rvasquez6089/Senior-Design-VFD/Inverter/3.3V2.5A Microcontroller Power/readme.txt

**********************************************************
*************  Important Instructions Follow  ************
**********************************************************

All files exported to: Z:\\17\\70\\1770687\\26\Altium\2016-06-17_13-27-20\2016-06-17_13-27-20

**********************************************************
***************** Schematic Instructions  ****************
**********************************************************

To import your new Schematic into Altium:

1. Unzip the downloaded folder files to a local directory and
Start the Altium program.
2. From the menu select "File"->"Open".
3. Select the file named in the path above ending with ".sch"
and "Open" the file.
4. Your Schematic should be viewable within Altium now.

For additional information, please visit this site:
http://www.accelerated-designs.com/help/Altium_BrdSch_import.html

**********************************************************
*******************  PCB Instructions  *******************
**********************************************************

To import your new BOARD into Altium:

1. Unzip the downloaded folder files to a local directory
	and Start the Altium program.
2. From the menu select "File"->"Open".
3. Select the file named in the path above ending with ".pcbdoc"
and "Open" the file.
4. Planes will need to be repoured to update the Copper Pour Polygons
	a. Once your board is loaded, select the Tools menu from the
	   top Menu Bar
	b. Scroll to the Polygon Pours item on the Tools Menu.
	c. The Polygon Pours item should expand to show more options
	d. Select Repour All Polygons, this will repour all of the
	   polygons.
5. Your board should be viewable within Altium now.

For additional information, please visit this site:
http://www.accelerated-designs.com/help/Altium_BrdSch_import.html

**********************************************************
*******************  LIB Instructions  *******************
**********************************************************

To import your new LIBRARY PARTS into Altium follow these steps:

1. After running the Ultra Librarian export for the first time,
you will need to copy the following files into an area where
they can be accessed for all future translations.  They are script
files that Altium will need to be able to find.
	a. UL_Form.dfm
	b. UL_Form.pas
	c. UL_Import.pas
	d. UL_Import.prjScr
2. The above script file will need to be run from within Altium.
This can be done by going to File, Open and selecting the
UL_Import.PrjScr file stored above.
3. Select the "DXP" dropdown menu in the top-left corner runfrom
the drop down menu and select "Run Script". Select "UL_Form.pas"
and click "OK"
4. When the script is run, it will ask you for the file name of the
Ultra Librarian file to run. Click "File...", select the latest file
produced with a date code (for instance 2010-02-17_23-12-34.txt), and
click "Start Import".
5. The script will open a new Integraged Library project and import
the Ultra Librarian data into it.  When complete a message box
will pop up saying that import is done.

For additional information, please visit this site:
http://www.accelerated-designs.com/help/Altium_import.html

For a video tutorial, please visit:
http://youtu.be/pih50yx9HYU

**********************************************************
**********************************************************
**********************************************************

Symbol "WB_STARTUP_VOLTAGE_SOURCE" renamed to "WB_STARTUP_VOLTA"
Symbol "WB_SOURCE_RESISTOR" renamed to "WB_SOURCE_RESIST"
Symbol "WB_PRIM_STARTUP_VOLTAGE_SOURCE" renamed to "WB_PRIM_STARTUP_"
Symbol "WB_PRIM_DC_VOLTAGE_SOURCE" renamed to "WB_PRIM_DC_VOLTA"
Symbol "WB_PWL_CURRENT_LOAD" renamed to "WB_PWL_CURRENT_L"
Symbol "WB_ZERO_VOLT_SOURCE" renamed to "WB_ZERO_VOLT_SOU"
Symbol "WB_PWL_VOLTAGE_SOURCE" renamed to "WB_PWL_VOLTAGE_S"
Symbol "WB_PRIM_PWL_VOLTAGE_SOURCE" renamed to "WB_PRIM_PWL_VOLT"
Symbol "WB_PRIMITIVE_BATTERY" renamed to "WB_PRIMITIVE_BAT"
Symbol "WB_TPS54329_EN_WIRE" renamed to "WB_TPS54329_EN_W"
Component "C0805C100M4GACTU" renamed to "C0805C100M4GACTU"
Component "GRM155R61A104KA01D" renamed to "GRM155R61A104KA0"
Component "WB_CONTINUATION" renamed to "WB_CONTINUATION"
Component "C3216JB1A476M" renamed to "C3216JB1A476M"
Component "GRM188R61A105KA61D" renamed to "GRM188R61A105KA6"
Component "GRM033R61A822KA01D" renamed to "GRM033R61A822KA0"
Component "WB_GND" renamed to "WB_GND"
Component "CLF7045T-3R3N" renamed to "CLF7045T-3R3N"
Component "CRCW040210K0FKED" renamed to "CRCW040210K0FKED"
Component "CRCW040225K5FKED" renamed to "CRCW040225K5FKED"
Component "CRCW040284K5FKED" renamed to "CRCW040284K5FKED"
Component "TPS54339DDAR" renamed to "TPS54339DDAR"
Component "WB_BATTERY" renamed to "WB_BATTERY"
Component "GRM155R60J225ME15D" renamed to "GRM155R60J225ME1"
Component "SLC7649S-101KLB" renamed to "SLC7649S-101KLB"
Component "WB_CURRENT_LOAD" renamed to "WB_CURRENT_LOAD"
Component "GRM32ER7YA106KA12L" renamed to "GRM32ER7YA106KA1"
The Symbol WB_BLOCK_IO was missing a RefDes attribute, a refdes was created for the symbol.
The Symbol WB_BLOCK_IO was missing a Type attribute, a type was created for the symbol.
The Symbol WB_BLOCK_IO was missing a Value attribute, a value was created for the symbol.
The Symbol WB_STARTUP_VOLTA was missing a RefDes attribute, a refdes was created for the symbol.
The Symbol WB_STARTUP_VOLTA was missing a Type attribute, a type was created for the symbol.
The Symbol WB_STARTUP_VOLTA was missing a Value attribute, a value was created for the symbol.
The Symbol WB_SOURCE_RESIST was missing a RefDes attribute, a refdes was created for the symbol.
The Symbol WB_SOURCE_RESIST was missing a Type attribute, a type was created for the symbol.
The Symbol WB_SOURCE_RESIST was missing a Value attribute, a value was created for the symbol.
The Symbol WB_PRIM_STARTUP_ was missing a RefDes attribute, a refdes was created for the symbol.
The Symbol WB_PRIM_STARTUP_ was missing a Type attribute, a type was created for the symbol.
The Symbol WB_PRIM_STARTUP_ was missing a Value attribute, a value was created for the symbol.
The Symbol WB_PRIM_DC_VOLTA was missing a RefDes attribute, a refdes was created for the symbol.
The Symbol WB_PRIM_DC_VOLTA was missing a Type attribute, a type was created for the symbol.
The Symbol WB_PRIM_DC_VOLTA was missing a Value attribute, a value was created for the symbol.
The Symbol WB_CURRENT_PROBE was missing a RefDes attribute, a refdes was created for the symbol.
The Symbol WB_CURRENT_PROBE was missing a Type attribute, a type was created for the symbol.
The Symbol WB_CURRENT_PROBE was missing a Value attribute, a value was created for the symbol.
The Symbol WB_PWL_CURRENT_L was missing a RefDes attribute, a refdes was created for the symbol.
The Symbol WB_PWL_CURRENT_L was missing a Type attribute, a type was created for the symbol.
The Symbol WB_PWL_CURRENT_L was missing a Value attribute, a value was created for the symbol.
The Symbol WB_ZERO_VOLT_SOU was missing a RefDes attribute, a refdes was created for the symbol.
The Symbol WB_ZERO_VOLT_SOU was missing a Type attribute, a type was created for the symbol.
The Symbol WB_ZERO_VOLT_SOU was missing a Value attribute, a value was created for the symbol.
The Symbol WB_PWL_VOLTAGE_S was missing a RefDes attribute, a refdes was created for the symbol.
The Symbol WB_PWL_VOLTAGE_S was missing a Type attribute, a type was created for the symbol.
The Symbol WB_PWL_VOLTAGE_S was missing a Value attribute, a value was created for the symbol.
The Symbol WB_PRIM_PWL_VOLT was missing a RefDes attribute, a refdes was created for the symbol.
The Symbol WB_PRIM_PWL_VOLT was missing a Type attribute, a type was created for the symbol.
The Symbol WB_PRIM_PWL_VOLT was missing a Value attribute, a value was created for the symbol.
The Symbol WB_LOAD_RESISTOR was missing a RefDes attribute, a refdes was created for the symbol.
The Symbol WB_LOAD_RESISTOR was missing a Type attribute, a type was created for the symbol.
The Symbol WB_LOAD_RESISTOR was missing a Value attribute, a value was created for the symbol.
The Symbol WB_PRIMITIVE_BAT was missing a RefDes attribute, a refdes was created for the symbol.
The Symbol WB_PRIMITIVE_BAT was missing a Type attribute, a type was created for the symbol.
The Symbol WB_PRIMITIVE_BAT was missing a Value attribute, a value was created for the symbol.
The Symbol WB_CFF_BLOCK was missing a RefDes attribute, a refdes was created for the symbol.
The Symbol WB_CFF_BLOCK was missing a Type attribute, a type was created for the symbol.
The Symbol WB_CFF_BLOCK was missing a Value attribute, a value was created for the symbol.
The Symbol WB_TPS54339 was missing a RefDes attribute, a refdes was created for the symbol.
The Symbol WB_TPS54339 was missing a Type attribute, a type was created for the symbol.
The Symbol WB_TPS54339 was missing a Value attribute, a value was created for the symbol.
The Symbol WB_VOLTAGE_PROBE was missing a RefDes attribute, a refdes was created for the symbol.
The Symbol WB_VOLTAGE_PROBE was missing a Type attribute, a type was created for the symbol.
The Symbol WB_VOLTAGE_PROBE was missing a Value attribute, a value was created for the symbol.
The Symbol WB_TPS54329_EN_W was missing a RefDes attribute, a refdes was created for the symbol.
The Symbol WB_TPS54329_EN_W was missing a Type attribute, a type was created for the symbol.
The Symbol WB_TPS54329_EN_W was missing a Value attribute, a value was created for the symbol.
The Symbol WB_TPS54329_VEN was missing a RefDes attribute, a refdes was created for the symbol.
The Symbol WB_TPS54329_VEN was missing a Type attribute, a type was created for the symbol.
The Symbol WB_TPS54329_VEN was missing a Value attribute, a value was created for the symbol.
WARNING schematic has been cleaned of missing information entries.
Warning: Symbol "WB_CAPACITOR" attribute "Datasheet URL" references missing text style ""
Warning: Symbol "WB_CAPACITOR" attribute "Cap" references missing text style ""
Warning: Symbol "WB_CAPACITOR" attribute "ESR" references missing text style ""
Warning: Symbol "WB_CAPACITOR" attribute "IRMS" references missing text style ""
Warning: Symbol "WB_CAPACITOR" attribute "VDC" references missing text style ""
Warning: Symbol "WB_CAPACITOR" attribute "Cap" references missing text style ""
Warning: Symbol "WB_CAPACITOR" attribute "ESR" references missing text style ""
Warning: Symbol "WB_CAPACITOR" attribute "IRMS" references missing text style ""
Warning: Symbol "WB_CAPACITOR" attribute "VDC" references missing text style ""
Warning: Symbol "WB_CAPACITOR" attribute "Datasheet URL" references missing text style ""
Warning: Symbol "WB_CAPACITOR" attribute "Cap" references missing text style ""
Warning: Symbol "WB_CAPACITOR" attribute "ESR" references missing text style ""
Warning: Symbol "WB_CAPACITOR" attribute "IRMS" references missing text style ""
Warning: Symbol "WB_CAPACITOR" attribute "VDC" references missing text style ""
Warning: Symbol "WB_CAPACITOR" attribute "Cap" references missing text style ""
Warning: Symbol "WB_CAPACITOR" attribute "ESR" references missing text style ""
Warning: Symbol "WB_CAPACITOR" attribute "IRMS" references missing text style ""
Warning: Symbol "WB_CAPACITOR" attribute "VDC" references missing text style ""
Warning: Symbol "WB_CAPACITOR" attribute "Cap" references missing text style ""
Warning: Symbol "WB_CAPACITOR" attribute "ESR" references missing text style ""
Warning: Symbol "WB_CAPACITOR" attribute "IRMS" references missing text style ""
Warning: Symbol "WB_CAPACITOR" attribute "VDC" references missing text style ""
Warning: Symbol "WB_INDUCTOR" attribute "Datasheet URL" references missing text style ""
Warning: Symbol "WB_INDUCTOR" attribute "L" references missing text style ""
Warning: Symbol "WB_INDUCTOR" attribute "DCR" references missing text style ""
Warning: Symbol "WB_INDUCTOR" attribute "IDC" references missing text style ""
Warning: Symbol "WB_RESISTOR" attribute "Resistance" references missing text style ""
Warning: Symbol "WB_RESISTOR" attribute "Power" references missing text style ""
Warning: Symbol "WB_RESISTOR" attribute "Tolerance" references missing text style ""
Warning: Symbol "WB_RESISTOR" attribute "Resistance" references missing text style ""
Warning: Symbol "WB_RESISTOR" attribute "Power" references missing text style ""
Warning: Symbol "WB_RESISTOR" attribute "Tolerance" references missing text style ""
Warning: Symbol "WB_RESISTOR" attribute "Resistance" references missing text style ""
Warning: Symbol "WB_RESISTOR" attribute "Power" references missing text style ""
Warning: Symbol "WB_RESISTOR" attribute "Tolerance" references missing text style ""
Warning: Symbol "TPS54339DDAR" attribute "Datasheet URL" references missing text style ""
Warning: Symbol "TPS54339DDAR" attribute "Frequency" references missing text style ""
Warning: Symbol "TPS54339DDAR" attribute "Imax" references missing text style ""
Warning: Symbol "TPS54339DDAR" attribute "Package" references missing text style ""
Warning: Symbol "TPS54339DDAR" attribute "Mktg_Package" references missing text style ""
Warning: Symbol "TPS54339DDAR" attribute "NSID" references missing text style ""
Warning: Symbol "WB_CAPACITOR" attribute "Datasheet URL" references missing text style ""
Warning: Symbol "WB_CAPACITOR" attribute "Cap" references missing text style ""
Warning: Symbol "WB_CAPACITOR" attribute "ESR" references missing text style ""
Warning: Symbol "WB_CAPACITOR" attribute "IRMS" references missing text style ""
Warning: Symbol "WB_CAPACITOR" attribute "VDC" references missing text style ""
Warning: Symbol "WB_INDUCTOR" attribute "Datasheet URL" references missing text style ""
Warning: Symbol "WB_INDUCTOR" attribute "L" references missing text style ""
Warning: Symbol "WB_INDUCTOR" attribute "DCR" references missing text style ""
Warning: Symbol "WB_INDUCTOR" attribute "IDC" references missing text style ""
Warning: Symbol "WB_CAPACITOR" attribute "Cap" references missing text style ""
Warning: Symbol "WB_CAPACITOR" attribute "ESR" references missing text style ""
Warning: Symbol "WB_CAPACITOR" attribute "IRMS" references missing text style ""
Warning: Symbol "WB_CAPACITOR" attribute "VDC" references missing text style ""
