rvasquez6089/Senior-Design-VFD/Power Factor Correction/Design Files/VFD.PcbDoc.htm

Reporting Options

# File in Newer Format

Date | : | 11/10/2017
Time | : | 4:26:10 PM
Filename | : | C:\Users\Ryan\Real Documents\Engineering Projects\Senior-Design-VFD\Power Factor Correction\Design Files\VFD.PcbDoc

Version | Warning
Release 17.0 | CAUTION - Component parameters added.
Release 17.0 | CAUTION - Supports of backdrilling

This file was generated by a later version of the software
