rvasquez6089/Senior-Design-VFD/Power Factor Correction/Design Files/UC2855A Calculations.xlsx

 |  |  | Vin(min) | 120 | Volts
 |  |  | Vin(Max) | 240 | Volts
 |  |  | Po(max) | 440 | Watts | (this is 1/2 Horsepower(372 watts) at 85% efficiency)
 |  |  | Vo | 350 | Volts
2.2 | Oscillator |  | Frequency | 250000
 |  |  | Capacitor CT | 3.571428571e-10
4.2 | Power Stage Design
4.2.1 | Inductor Design | Peak Current | Ipk | 5.458368135 | Amps | (assuming 95% efficiency)
 |  | Inductor Current Ripple | I(Ripple) | 1.091673627 | Amps | Assuming 20% Ripple Ratio
 |  | Conversion Ratio | D | 0.5151267786 | Ratio
 |  |  | L1 | 0.0004414909091 | Henries
