rvasquez6089/Senior-Design-VFD/tek00000.bmp

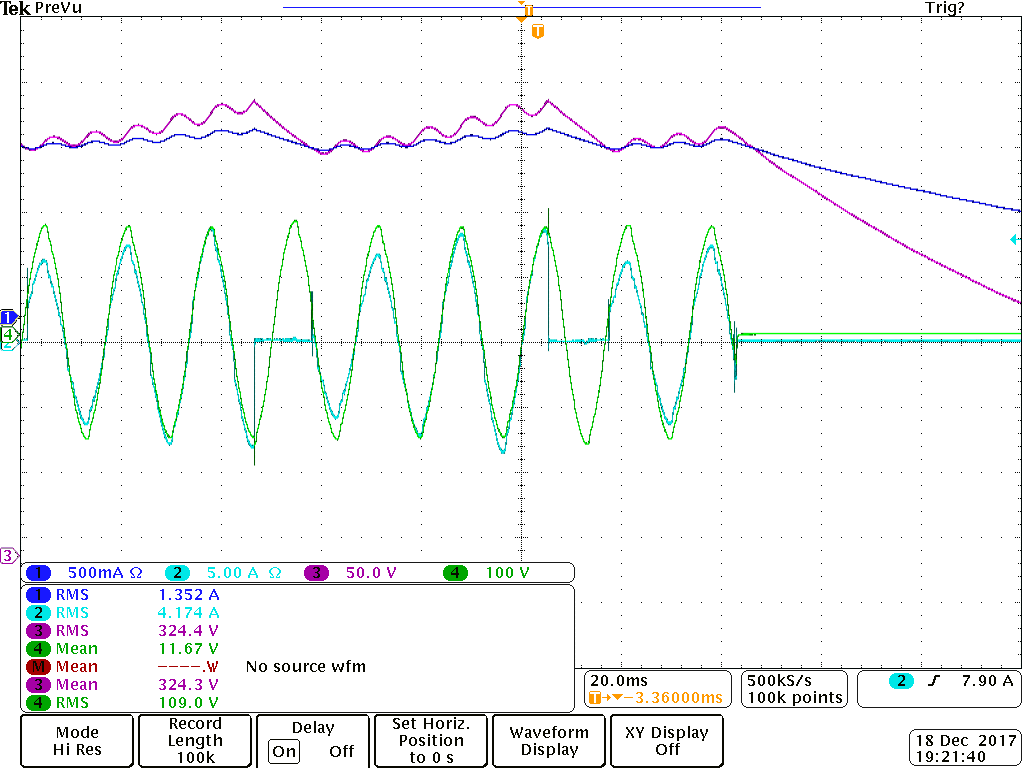
tek00000.bmp
