rvasquez6089/Senior-Design-VFD/tek00001.bmp

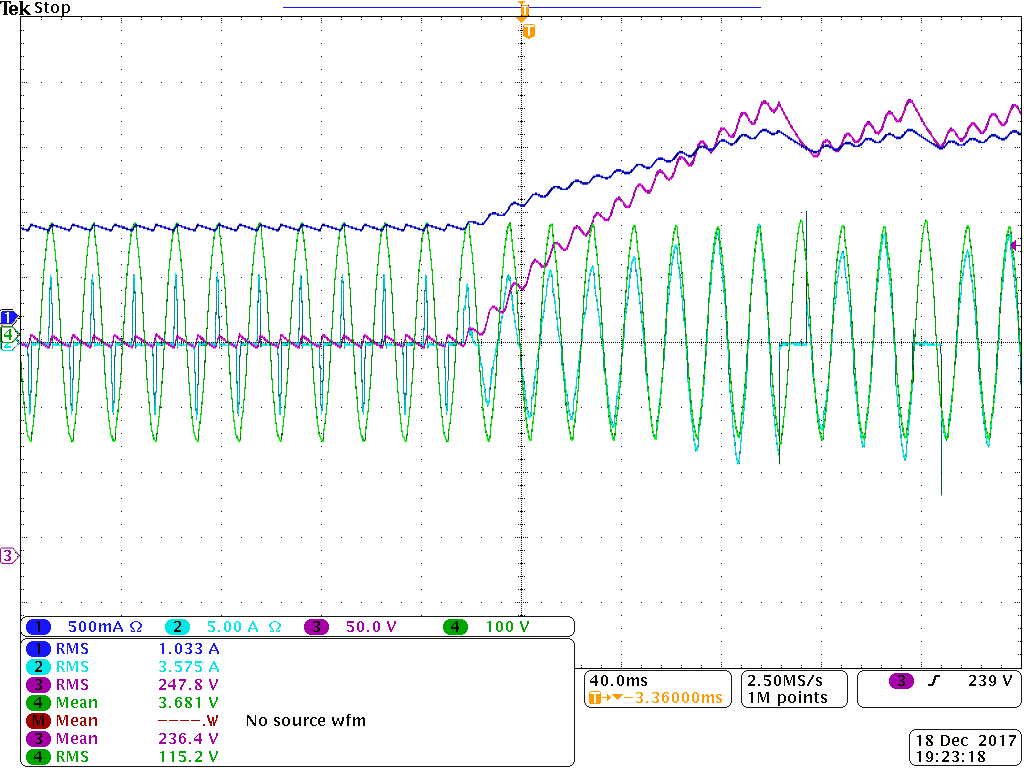
tek00001.bmp
