rvasquez6089/Senior-Design-VFD/tek00002.bmp

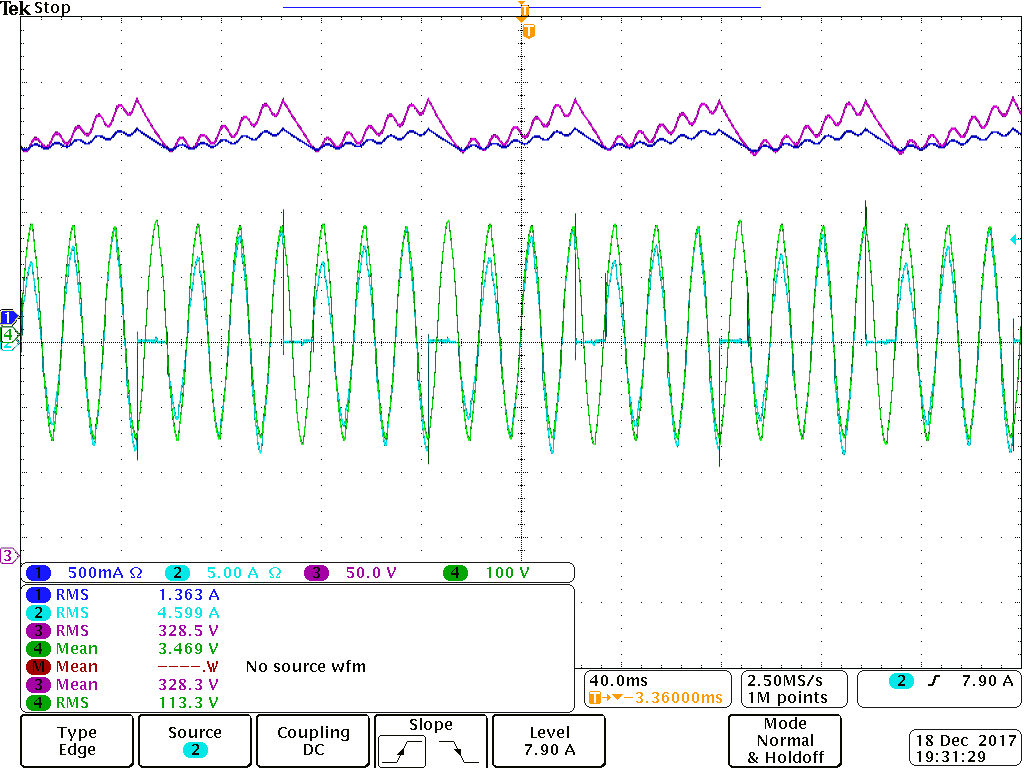
tek00002.bmp
