rvasquez6089/Senior-Design-VFD/Inverter/Project Outputs for Inverter/Inverter BOM.xls

Designator | Manufacturer 1 | Manufacturer Part Number 1 | Quantity | Alternate #
3.3V, HIN1, HIN2, HIN3, LIN1, LIN2, LIN3, TP7, TP8, TP9, TP10 | TE Connectivity AMP Connectors | RCS-0C | 11
C1 | Murata Electronics North America | GRM155R61A104KA01D | 1
C10 | AVX Corporation | 08055C182KAT2A | 1
C12HB1, C12HB2, C12HB3, C13HB1, C13HB2, C13HB3 | Samsung Electro-Mechanics | CL31B225KBHNNNE | 6
C14HB1, C14HB2, C14HB3, C15HB1, C15HB2, C15HB3 | AVX Corporation | 06123C224KAT2A | 6
C18HB1, C18HB2, C18HB3, C19HB1, C19HB2, C19HB3 | Murata Electronics North America | GCM188R72A102KA37D | 6
C22 | AVX Corporation | TAJP106M010RNJ | 1
C2B1, C2B2, C2B3, C2B4, C2B5, C2B6, C2B7, C2B8, C9, C16, C17, C20, C21, C23, C24, C25, C26, C27, C28 | Murata Electronics North America | GRM188R71H104KA93D | 19
C3 | KEMET | C0805C100M4GACTU | 1
C37, C38, C39, C40, C41, C42 | Murata Electronics North America | GRM21BR71H474KA88K | 6
C4, C5 | Murata Electronics North America | GRM32ER7YA106KA12L | 2
C6 | KEMET | T520D107M010ATE080 | 1
C7 | Murata Electronics North America | GRM188R61A105KA61D | 1
C8 | TDK Corporation | C3216JB1A476M160AB | 1
D1HB1, D1HB2, D1HB3 | Micro Commercial Co | ER2J-LTP | 3
D2HB1, D2HB2, D2HB3 | ON Semiconductor | MBR1020VL | 3
FB1 | TDK Corporation | MMZ1608A222B | 1
J1, J2, J3 | JST Sales America Inc. | B3B-PH-K-S(LF)(SN) | 3
L1 | TDK Corporation | CLF7045T-3R3N | 1
LED1 | Lite-On Inc. | LTST-C190GKT | 1
LED2HB1, LED2HB2, LED2HB3, LED5, LED6, LED12, LED14 | Kingbright | APT1608CGCK | 7
LED3HB1, LED3HB2, LED3HB3, LED4B1, LED4B2, LED4B3, LED4B4, LED4B5, LED4B6, LED4B7, LED4B8, LED16 | OSRAM Opto Semiconductors Inc. | LO L296-Q2S1-24-Z | 12
LED8, LED10 | Kingbright Company LLC | APT1608SURCK | 2
P1, P2 | TE Connectivity AMP Connectors | 796739-3 | 2
Q1HB1, Q1HB2, Q1HB3, Q2HB1, Q2HB2, Q2HB3 | Cree/Wolfspeed | C3M0280090J | 6
Q3HB1, Q3HB2, Q3HB3, Q4HB1, Q4HB2, Q4HB3, Q5B1, Q5B2, Q5B3, Q5B4, Q5B5, Q5B6, Q5B7, Q5B8, Q6, Q9, Q12, Q14, Q16 | Vishay Siliconix | SI2304DDS-T1-GE3 | 19
R1, R15HB1, R15HB2, R15HB3, R16HB1, R16HB2, R16HB3, R33, R38, R44, R48, R52 | Vishay Dale | CRCW040210K0FKED | 12
R10HB1, R10HB2, R10HB3, R12HB1, R12HB2, R12HB3 | Panasonic Electronic Components | ERJ-6DQJ3R0V | 6
R18HB1, R18HB2, R18HB3, R19HB1, R19HB2, R19HB3 | Panasonic Electronic Components | ERJ-6ENF26R1V | 6
R20HB1, R20HB2, R20HB3 | Vishay/Dale | CRCW0603100KFKEA | 3
R21, R22 | Vishay/Dale | CRCW0805205KFKEA | 2
R23 | Panasonic Electronic Components | ERJ-3EKF3401V | 1
R24 | Bourns Inc. | PDB12-H4251-103BF | 1
R26 | Yageo | RC0603FR-07100RL | 1
R2B1, R2B2, R2B3, R2B4, R2B5, R2B6, R2B7, R2B8, R13HB1, R13HB2, R13HB3, R14HB1, R14HB2, R14HB3, R28, R30, R34, R36, R41, R45, R49 | Yageo | RC0603JR-0768RL | 21
R3B1, R3B2, R3B3, R3B4, R3B5, R3B6, R3B7, R3B8 | Panasonic Electronic Components | ERJ-3EKF4702V | 8
R4 | Vishay Dale | CRCW040284K5FKED | 1
R5 | Yageo | RC0402JR-0768RL | 1
R6, R8, R25 | Yageo | RC0603FR-074K7L | 3
R7 | Vishay Dale | CRCW040225K5FKED | 1
R9HB1, R9HB2, R9HB3, R11HB1, R11HB2, R11HB3 | Samsung Electro-Mechanics America, Inc (https://octopart-clicks.com/click/altium?sku=RHM0.0CPDKR-ND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) | RC2012J000CS (https://octopart-clicks.com/click/altium?sku=RHM0.0CPDKR-ND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) | 6
S1 | E-Switch | TL3301AF160QJ | 1
S2B1, S2B2, S2B3, S2B4, S2B5, S2B6, S2B7, S2B8 | C&K | PVA1 OA H1 1.2N V2 | 8
SNK1HB1, SNK1HB2, SNK1HB3 | Advanced Thermal Solutions Inc. | ATS-CPX025025010-137-C2-R0 | 3
TR1HB1, TR1HB2, TR1HB3 |  |  | 3
U1 | Texas Instruments | TPS54339DDAR | 1
U3HB1, U3HB2, U3HB3 | ON Semiconductor | FAN7390MX | 3
U4 | ON Semiconductor | NCP51460SN33T1G | 1
U5 | Microchip Technology | DSPIC33EP64MC206-I/PT | 1
