rvasquez6089/Senior-Design-VFD/Power Factor Correction/Data Sheets/Possible PFC Chips.xlsx

PFC
 | Manufacturer | Model # | Pros | Cons
 | TI | UCC2818A-Q1 | ·No coupled inductor needed for design. Decent example schamtic and design in datasheet, contains model numbers ect ect | High pin count
 | TI | UCC28019A | Low Pin Count. Very simple circuit. Included Spreadsheet calculator | Low Switching Frequency. Really high inductance, how to find inductor
 | TI | UC2855A (http://www.ti.com/product/uc2855a) | High switching frequency | Very Complex design. Poor Datasheet. Unitrode
 | TI | UC2855B (http://www.ti.com/product/uc2855b)
