rvasquez6089/Senior-Design-VFD/Power Factor Correction/Design Files/Project Outputs for Power-Factor-Correction/Power-Factor-Correction BOM .xls

Designator | Manufacturer 1 | Manufacturer Part Number 1 | Quantity | Supplier Order Qty 1 | Supplier Subtotal 1 | Supplier Unit Price 1
U1 | Texas Instruments | UC2855BDW | 1 | 1 | 15.12 | 15.12
SNK1 | Wakefield-Vette | OMNI-UNI-41-75 | 1 | 1 | 13.42 | 13.42
Q1 | Cree/Wolfspeed | C3M0065090D | 1 | 1 | 10.5 | 10.5
D2, D8, D9 | Cree/Wolfspeed | C3D06065I | 3 | 3 | 9.66 | 3.22
SNK2 | Ohmite | C247-025-1AE | 1 | 1 | 4.01 | 4.01
TP2, TP3, TP4, TP5, TP6, TP7, TP8, TP9, TP10, TP11, TP12, TP13, TP14, TP15, TP16 | TE Connectivity AMP Connectors | RCS-0C | 15 | 15 | 3.915 | 0.261
C1, C6 | KEMET | R71MI4100AA30K | 2 | 2 | 2.08 | 1.04
D1 | Diodes Incorporated | GBJ2506-F | 1 | 1 | 1.45 | 1.45
F1 | Littelfuse Inc. | 03540101ZXGY | 1 | 1 | 1.25 | 1.25
D4, D7, D10 | ON Semiconductor | MBR1020VL | 3 | 3 | 1.17 | 0.39
D3, D6 | Diodes Incorporated | B320A-13-F | 2 | 2 | 1.14 | 0.57
C13 | Murata Electronics North America | GRM43DR72J104KW01L | 1 | 1 | 0.72 | 0.72
C21 | Taiyo Yuden | UMK325BJ106MM-T | 1 | 1 | 0.59 | 0.59
C17, C18 | Taiyo Yuden | GMK316B7105KL-T | 2 | 2 | 0.56 | 0.28
C15 | AVX Corporation (https://octopart-clicks.com/click/altium?sku=C0603C181F5GACTU-ND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) | 06035A181FAT2A (https://octopart-clicks.com/click/altium?sku=C0603C181F5GACTU-ND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) | 1 | 1 | 0.55 | 0.55
VR1 | EPCOS (TDK) | B72214S0251K101 | 1 | 1 | 0.52 | 0.52
C14 | AVX Corporation (https://octopart-clicks.com/click/altium?sku=399-7876-1-ND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) | 06035A221FAT2A (https://octopart-clicks.com/click/altium?sku=399-7876-1-ND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) | 1 | 1 | 0.49 | 0.49
C11 | Murata Electronics North America | GRM31A7U3A121JW31D | 1 | 1 | 0.48 | 0.48
D5 | ON Semiconductor | ES1JAF | 1 | 1 | 0.42 | 0.42
R5, R6, R9, R10 | Panasonic Electronic Components | ERJ-6GEYJ394V | 4 | 4 | 0.4 | 0.1
Q3 | ON Semiconductor | PZT3906 | 1 | 1 | 0.38 | 0.38
C12 | Murata Electronics North America | GRM2195C1H622JA01D | 1 | 1 | 0.35 | 0.35
C16 | Murata Electronics North America | GRM21BR71H474KA88K | 1 | 1 | 0.35 | 0.35
C8, C9, C19 | Murata Electronics North America | GCM188R72A102KA37D | 3 | 3 | 0.3 | 0.1
C22, C23 | Kemet | C0805C104K5RACTU | 2 | 2 | 0.2 | 0.1
R2, R3 | Panasonic Electronic Components | ERJ-6ENF26R1V | 2 | 2 | 0.2 | 0.1
R7, R17 | Panasonic Electronic Components | ERJ-3EKF1004V | 2 | 2 | 0.2 | 0.1
R12, R22 | Panasonic Electronic Components | ERJ-3GEYJ2R7V | 2 | 2 | 0.2 | 0.1
R14, R19 | Panasonic Electronic Components | ERJ-6ENF6813V | 2 | 2 | 0.2 | 0.1
R15, R23 | Yageo | RC0603FR-075R1L | 2 | 2 | 0.2 | 0.1
C24 | Murata Electronics North America | GRM188R71H823KA93D | 1 | 1 | 0.18 | 0.18
R13 | Panasonic Electronic Components | ERJ-PA3F1203V | 1 | 1 | 0.16 | 0.16
C10 | Murata Electronics North America | GRM1885C1H221JA01D | 1 | 1 | 0.12 | 0.12
C25 | Murata Electronics North America | GRM188R71H104KA93D | 1 | 1 | 0.12 | 0.12
C7 | Murata Electronics North America | GRM1885C1H330JA01D | 1 | 1 | 0.1 | 0.1
R1 | Vishay/Dale | CRCW0603100KFKEA | 1 | 1 | 0.1 | 0.1
R4 | Yageo | RC0603FR-071KL | 1 | 1 | 0.1 | 0.1
R11 | Panasonic Electronic Components | ERJ-3EKF2611V | 1 | 1 | 0.1 | 0.1
R16 | Panasonic Electronic Components | ERJ-3EKF1802V | 1 | 1 | 0.1 | 0.1
R18 | Panasonic Electronic Components | ERJ-3EKF1204V | 1 | 1 | 0.1 | 0.1
R20 | Panasonic Electronic Components | ERJ-3EKF2203V | 1 | 1 | 0.1 | 0.1
R21 | Panasonic Electronic Components | ERJ-3EKF3161V | 1 | 1 | 0.1 | 0.1
R24 | Panasonic Electronic Components | ERJ-3EKF1803V | 1 | 1 | 0.1 | 0.1
R25 | Panasonic Electronic Components | ERJ-3EKF4422V | 1 | 1 | 0.1 | 0.1
R26 | Panasonic Electronic Components | ERJ-3EKF1132V | 1 | 1 | 0.1 | 0.1
L3, TR1 |  |  | 2
R8 | Yageo | RC0603JR-073K3L | 1 | 1
R27 | Murata Electronics North America | PV36Y102C01B00 | 1 | 1
 |  |  |  |  | 72.705
