rvasquez6089/Senior-Design-VFD/Power Factor Correction/Design Files/3D models/VFD.SLDASM

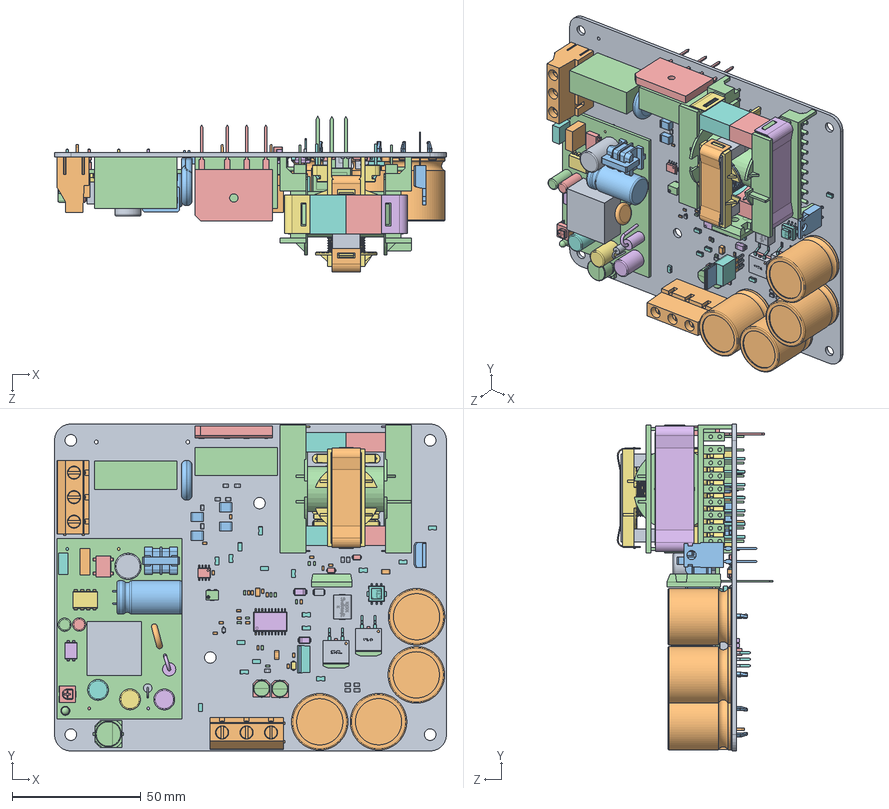
[picture p4: CAD file, 2017-10-23]
Power Factor Correction/Design Files/3D models/VFD.SLDASM
152.4 x 127.1 x 60.5 mm
Board
RES_0603_(1608_metric) x 19
User_Library-CAPSMD6_3x3_9_CAP003 x 2
User_Library-CAPSMD6_3x3_9_CAP x 2
User_Library-CAPSMD6_3x3_9_CAP001 x 2
User_Library-CAPSMD6_3x3_9_CAP002 x 2
User_Library-CAPSMD6_3x3_9_CAP004 x 2
c-1625854-1-ba-3d x 16
SOD323
c-796739-3-b-3d x 2
User_Library-S14K25_MOV
User_Library-ETD44_NO_AIRGAP_CoilFormerETD44
User_Library-ETD44_NO_AIRGAP_ETD44_core1
User_Library-ETD44_NO_AIRGAP_ClipETD44_2
User_Library-ETD44_NO_AIRGAP_ClipETD44_1
User_Library-ETD44_NO_AIRGAP_ETD44_core2
Open_CASCADE_STEP_translator_6.8_1.1.1
lead x 2
User_Library-TO_220-2
User_Library-PG-TO247-3-21
Open_CASCADE_STEP_translator_6.8_1.1
Open_CASCADE_STEP_translator_6.8_1.2.1
Leader x 20
Coilcraft-CST1
RES_0805_(2012_metric) x 13
CAPC3216X180N_-_1206_(3216_metric) x 3
CAP_1812 x 4
CAP_0603 x 10
Open_CASCADE_STEP_translator_6.8_1.1.1_2 x 2
lead_2 x 4
SW3dPS-TO263-3S_Board9 x 2
SW3dPS-TO263-3S_Extruded14 x 4
SW3dPS-TO263-3S_Extruded11 x 2
SW3dPS-TO263-3S_Cylinder1 x 2
SW3dPS-TO263-3S_Extruded12 x 2
SW3dPS-TO263-3S_Extruded21 x 2
SW3dPS-TO263-3S_Extruded16 x 2
SW3dPS-TO263-3S_Extruded19 x 2
SW3dPS-TO263-3S_Board5 x 4
SW3dPS-TO263-3S_Extruded13 x 4
SW3dPS-TO263-3S_Extruded18 x 2
SW3dPS-TO263-3S_Board7 x 2
SW3dPS-TO263-3S_Board6 x 2
SW3dPS-TO263-3S_Extruded15 x 2
SW3dPS-TO263-3S_Extruded17 x 2
SW3dPS-TO263-3S_Board8 x 2
SW3dPS-TO263-3S_Extruded20 x 2
42ctq030
Extruded x 3
Extruded_2 x 3
Extruded_3
Extruded_4 x 2
GBJ_4-SIP
SW3dPS-DO-214AC_SMA x 2
Open_CASCADE_STEP_translator_6.8_1.1.1_3
lead_3 x 2
Coilcraft-SLR1050x
User_Library-ECEC2DP271BJ x 4
User_Library-CAP_EL_SNAP-IN_10_35x45_Valor_predeterminado x 8
User_Library-cap_10x10x8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
