rvasquez6089/Senior-Design-VFD/(list of files, cad)

Other CAD files:
Power Factor Correction/Design Files/3D models/TR1.sldasm
Power Factor Correction/Design Files/3D models/TP6.sldasm
Power Factor Correction/Design Files/3D models/TP8.sldasm
Power Factor Correction/Design Files/3D models/C19.sldasm
Power Factor Correction/Design Files/3D models/C25.sldasm
Power Factor Correction/Design Files/3D models/TP3.sldasm
Power Factor Correction/Design Files/3D models/SW3dPS-TO263-3S_450154961.sldasm
Power Factor Correction/Design Files/3D models/R2.sldasm
Power Factor Correction/Design Files/3D models/R32.sldasm
Power Factor Correction/Design Files/3D models/User_Library-ETD34-17-11_Vertical_Bobbin_Part_No._FD9640.sldasm
Power Factor Correction/Design Files/3D models/C4.sldasm
Power Factor Correction/Design Files/3D models/User_Library-CAPSMD6_3x7.sldasm
Power Factor Correction/Design Files/3D models/R29.sldasm
Power Factor Correction/Design Files/3D models/Q2.sldasm
Power Factor Correction/Design Files/3D models/SW3dPS-TO263-3S_450154833.sldasm
Power Factor Correction/Design Files/3D models/SW3dPS-TO263-3S_453494225.sldasm
Power Factor Correction/Design Files/3D models/C24.sldasm
Power Factor Correction/Design Files/3D models/C2.sldasm
Power Factor Correction/Design Files/3D models/C16.sldasm
Power Factor Correction/Design Files/3D models/R8.sldasm
Power Factor Correction/Design Files/3D models/C7.sldasm
Power Factor Correction/Design Files/3D models/TR2.sldasm
Power Factor Correction/Design Files/3D models/R15.sldasm
Power Factor Correction/Design Files/3D models/D1.sldasm
Power Factor Correction/Design Files/3D models/C18.sldasm
Power Factor Correction/Design Files/3D models/SW3dPS-TO263-3S_450155217.sldasm
Power Factor Correction/Design Files/3D models/C5.sldasm
Power Factor Correction/Design Files/3D models/TP9.sldasm
Power Factor Correction/Design Files/3D models/Capacitor22x25.sldasm
Power Factor Correction/Design Files/3D models/C29.sldasm
Power Factor Correction/Design Files/3D models/R7.sldasm
Power Factor Correction/Design Files/3D models/C14.sldasm
Power Factor Correction/Design Files/3D models/TP17.sldasm
Power Factor Correction/Design Files/3D models/R24.sldasm
Power Factor Correction/Design Files/3D models/SW3dPS-TO263-3S_450155089.sldasm
Power Factor Correction/Design Files/3D models/C8.sldasm
Power Factor Correction/Design Files/3D models/C11.sldasm
Power Factor Correction/Design Files/3D models/C3.sldasm
Power Factor Correction/Design Files/3D models/R9.sldasm
Power Factor Correction/Design Files/3D models/R14.sldasm
Power Factor Correction/Design Files/3D models/R20.sldasm
Power Factor Correction/Design Files/3D models/Body_3.sldasm
Power Factor Correction/Design Files/3D models/R31.sldasm
Power Factor Correction/Design Files/3D models/D7.sldasm
Power Factor Correction/Design Files/3D models/R22.sldasm
Power Factor Correction/Design Files/3D models/SW3dPS-TO263-3S_Free-Models8.sldasm
Power Factor Correction/Design Files/3D models/L2.sldasm
Power Factor Correction/Design Files/3D models/D11.sldasm
Power Factor Correction/Design Files/3D models/C17.sldasm
Power Factor Correction/Design Files/3D models/Body_4.sldasm
Power Factor Correction/Design Files/3D models/R19.sldasm
Power Factor Correction/Design Files/3D models/SW3dPS-TO263-3S_453494353.sldasm
Power Factor Correction/Design Files/3D models/U2.sldasm
Power Factor Correction/Design Files/3D models/R3.sldasm
Power Factor Correction/Design Files/3D models/SW3dPS-TO263-3S_BODY3.sldasm
Power Factor Correction/Design Files/3D models/D4.sldasm
Power Factor Correction/Design Files/3D models/C27.sldasm
Power Factor Correction/Design Files/3D models/D5.sldasm
Power Factor Correction/Design Files/3D models/P1.sldasm
Power Factor Correction/Design Files/3D models/SW3dPS-TO263-3S_BODY5.sldasm
Power Factor Correction/Design Files/3D models/C9.sldasm
Power Factor Correction/Design Files/3D models/SW3dPS-TO263-3S_450155985.sldasm
Power Factor Correction/Design Files/3D models/TP14.sldasm
Power Factor Correction/Design Files/3D models/SW3dPS-TO263-3S_449923505.sldasm
Power Factor Correction/Design Files/3D models/R10.sldasm
Power Factor Correction/Design Files/3D models/R28.sldasm
Power Factor Correction/Design Files/3D models/D6.sldasm
Power Factor Correction/Design Files/3D models/C15.sldasm
Power Factor Correction/Design Files/3D models/C22.sldasm
Power Factor Correction/Design Files/3D models/R1.sldasm
Power Factor Correction/Design Files/3D models/SW3dPS-TO263-3S_Free-Models7.sldasm
Power Factor Correction/Design Files/3D models/U1.sldasm
Power Factor Correction/Design Files/3D models/C10.sldasm
Power Factor Correction/Design Files/3D models/ETD_34_Vertical.sldasm
Power Factor Correction/Design Files/3D models/SW3dPS-TO263-3S_Free-Models6.sldasm
Power Factor Correction/Design Files/3D models/R13.sldasm
Power Factor Correction/Design Files/3D models/TP11.sldasm
Power Factor Correction/Design Files/3D models/TP15.sldasm
Power Factor Correction/Design Files/3D models/R5.sldasm
Power Factor Correction/Design Files/3D models/L1.sldasm
Power Factor Correction/Design Files/3D models/SW3dPS-TO263-3S_Free-Models5.sldasm
Power Factor Correction/Design Files/3D models/SW3dPS-TO263-3S_453496017.sldasm
Power Factor Correction/Design Files/3D models/R11.sldasm
Power Factor Correction/Design Files/3D models/D8.sldasm
Power Factor Correction/Design Files/3D models/R12.sldasm
Power Factor Correction/Design Files/3D models/TP10.sldasm
Power Factor Correction/Design Files/3D models/C26.sldasm
Power Factor Correction/Design Files/3D models/R17.sldasm
Power Factor Correction/Design Files/3D models/TP16.sldasm
Power Factor Correction/Design Files/3D models/SW3dPS-TO263-3S_453496145.sldasm
Power Factor Correction/Design Files/3D models/TP7.sldasm
Power Factor Correction/Design Files/3D models/TP4.sldasm
Power Factor Correction/Design Files/3D models/SW3dPS-TO263-3S_PIN1.sldasm
Power Factor Correction/Design Files/3D models/SW3dPS-TO263-3S_BODY4.sldasm
Power Factor Correction/Design Files/3D models/R23.sldasm
Power Factor Correction/Design Files/3D models/R18.sldasm
Power Factor Correction/Design Files/3D models/SW3dPS-TO263-3S_450155473.sldasm
Power Factor Correction/Design Files/3D models/User_Library-ETD44_NO_AIRGAP.sldasm
Power Factor Correction/Design Files/3D models/R21.sldasm
Power Factor Correction/Design Files/3D models/D3.sldasm
Power Factor Correction/Design Files/3D models/Body.sldasm
Power Factor Correction/Design Files/3D models/SW3dPS-TO263-3S_Free-Models9.sldasm
Power Factor Correction/Design Files/3D models/R25.sldasm
Power Factor Correction/Design Files/3D models/D10.sldasm
Power Factor Correction/Design Files/3D models/Q1.sldasm
Power Factor Correction/Design Files/3D models/D9.sldasm
Power Factor Correction/Design Files/3D models/C21.sldasm
Power Factor Correction/Design Files/3D models/R16.sldasm
Power Factor Correction/Design Files/3D models/C6.sldasm
Power Factor Correction/Design Files/3D models/R6.sldasm
Power Factor Correction/Design Files/3D models/R4.sldasm
Power Factor Correction/Design Files/3D models/C13.sldasm
Power Factor Correction/Design Files/3D models/TP2.sldasm
Power Factor Correction/Design Files/3D models/C28.sldasm
Power Factor Correction/Design Files/3D models/VR1.sldasm
Power Factor Correction/Design Files/3D models/TP5.sldasm
Power Factor Correction/Design Files/3D models/R30.sldasm
Power Factor Correction/Design Files/3D models/TP13.sldasm
Power Factor Correction/Design Files/3D models/R26.sldasm
Power Factor Correction/Design Files/3D models/C23.sldasm
Power Factor Correction/Design Files/3D models/MOD1.sldasm
Power Factor Correction/Design Files/3D models/TP12.sldasm
Power Factor Correction/Design Files/3D models/L3.sldasm
Power Factor Correction/Design Files/3D models/C12.sldasm
Power Factor Correction/Design Files/3D models/P2.sldasm
Power Factor Correction/Design Files/3D models/SW3dPS-TO263-3S_450156369.sldasm
Power Factor Correction/Design Files/3D models/C20.sldasm
Power Factor Correction/Design Files/3D models/R27.sldasm
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
