rvasquez6089/Senior-Design-VFD/Power Factor Correction/Design Files/Power Factor Correction.pdf

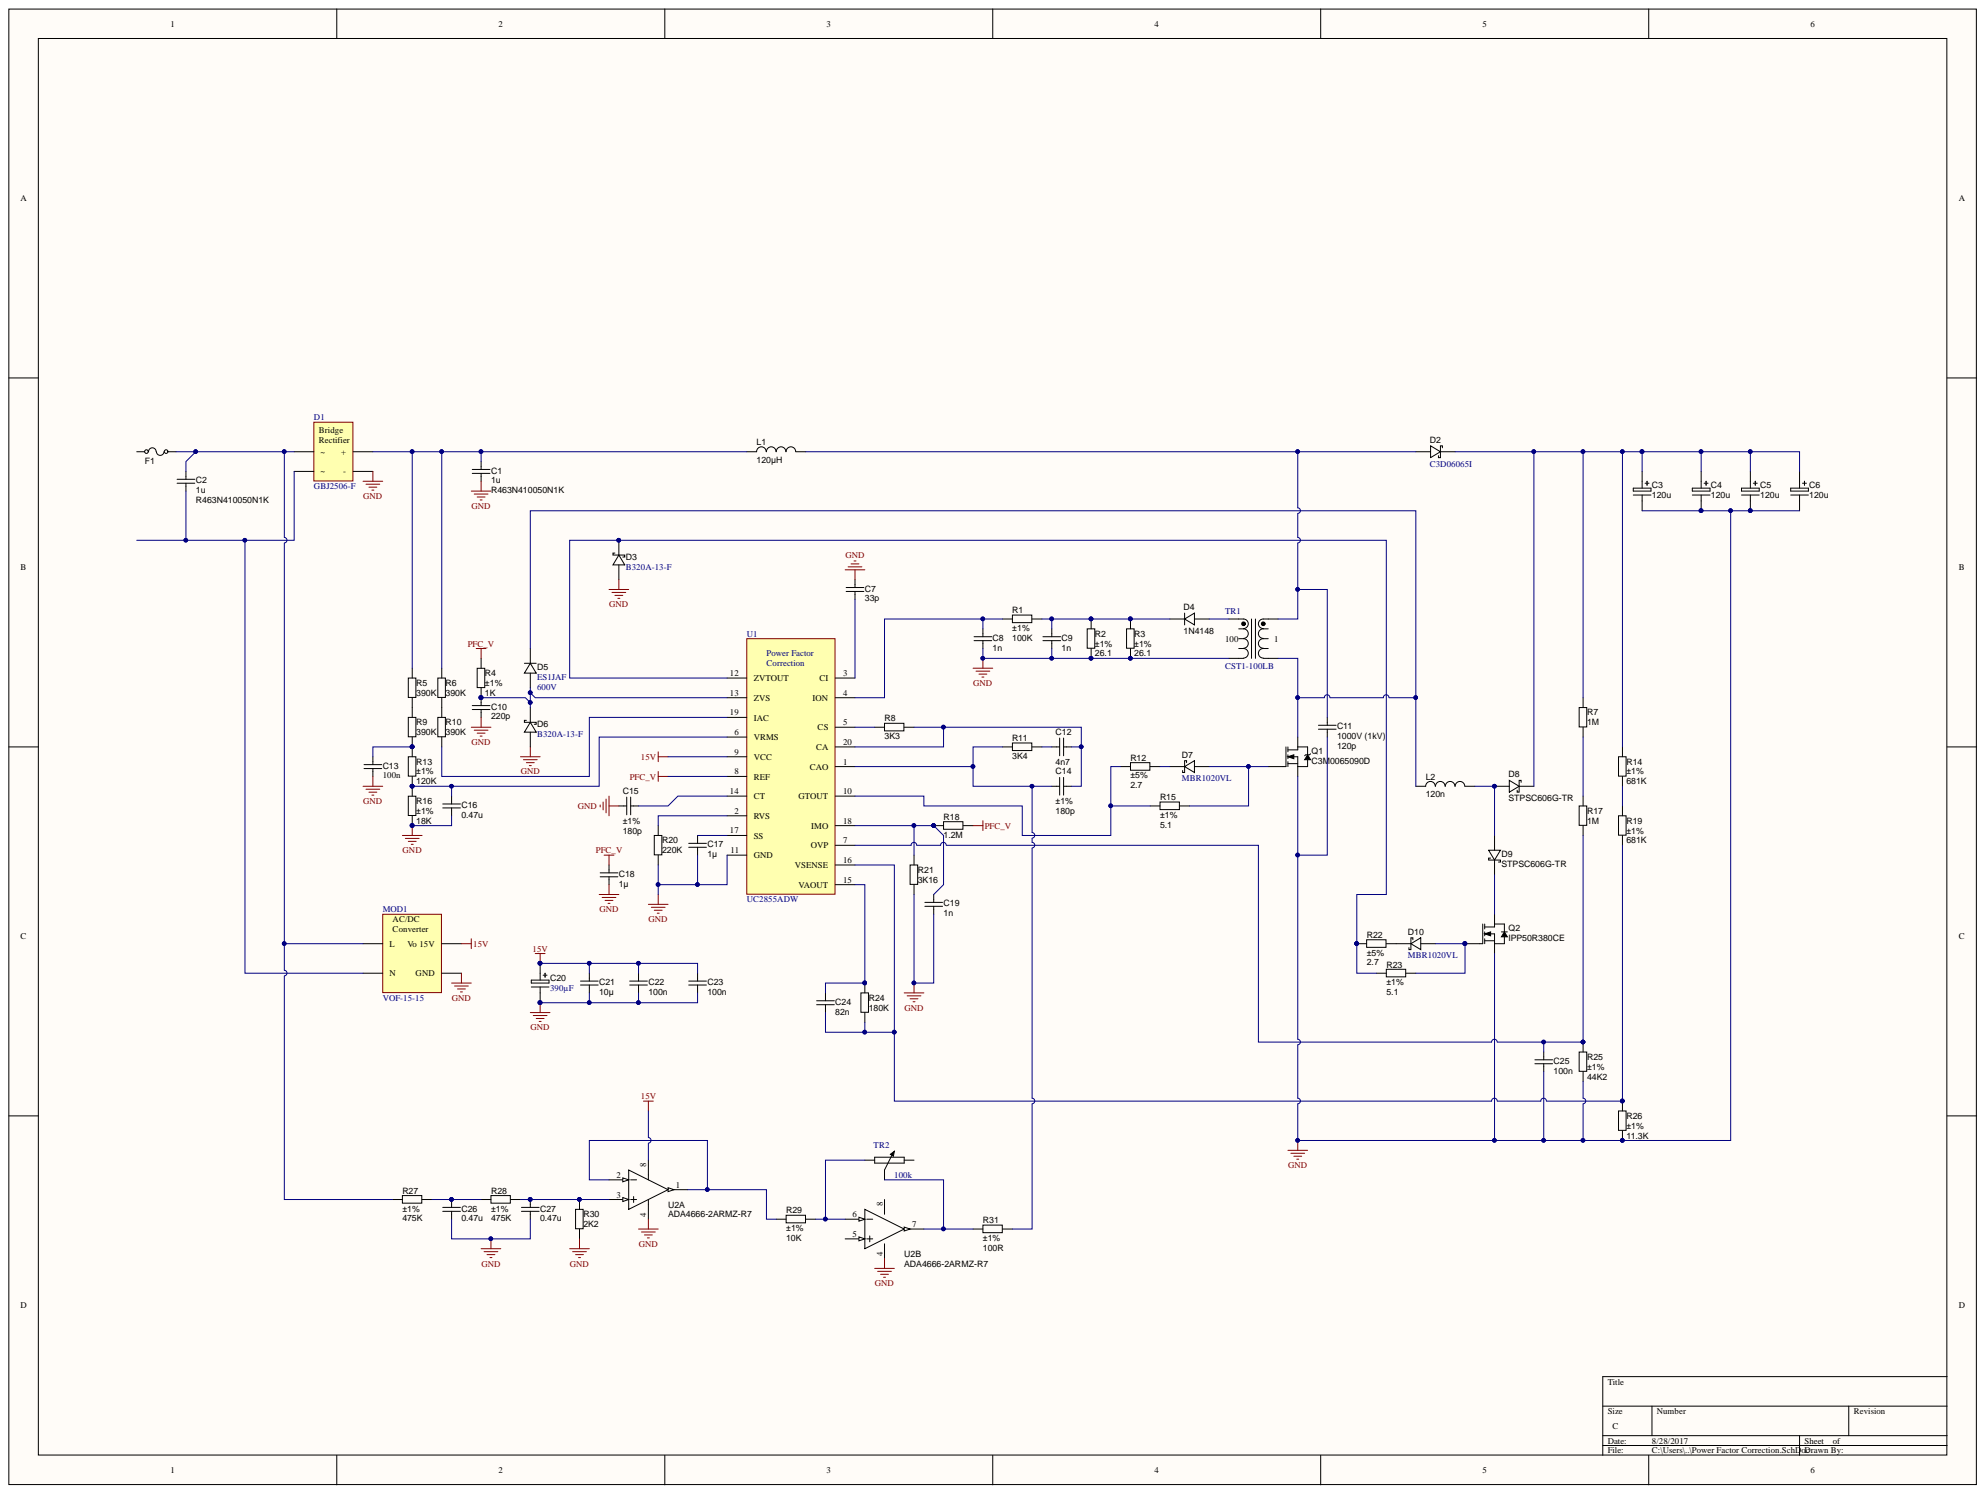
[picture p5: page 1]

1 9 | IAC C S VRMS C A VC C CAO REF C T GTOUT RVS IMO SS OVP GND VSENSE | 5 R8 | C3M0065090D | C1 1 | )
