rvasquez6089/Senior-Design-VFD/Inverter/Inverter Main.pdf

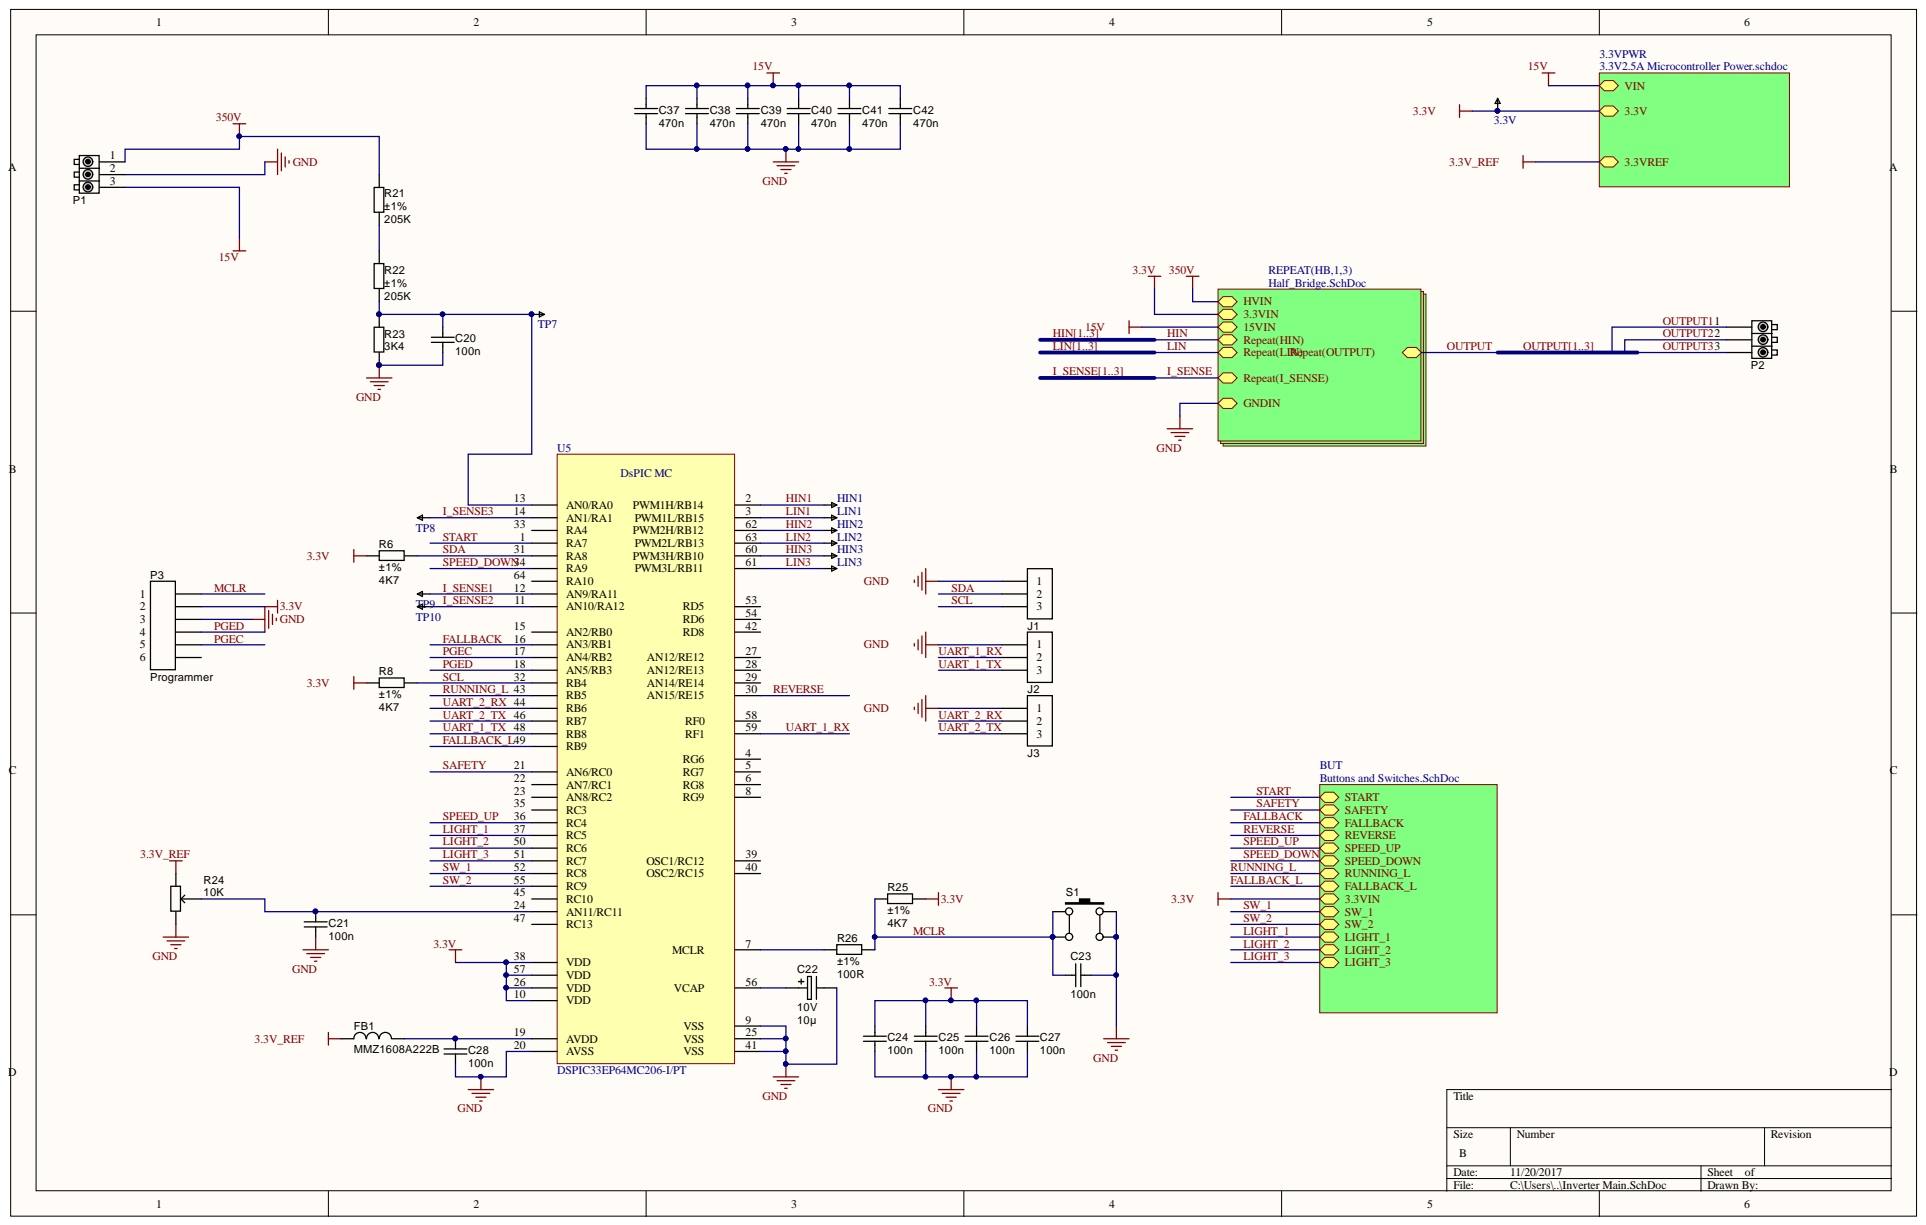
[picture p6: page 1]

Size B | Number | Revision

Date: 11/20/2017 | Sheet of
File: C:\Users\..\Inverter Main.SchDoc | Drawn By:
