rvasquez6089/Senior-Design-VFD/Inverter/Buttons and Switches.pdf

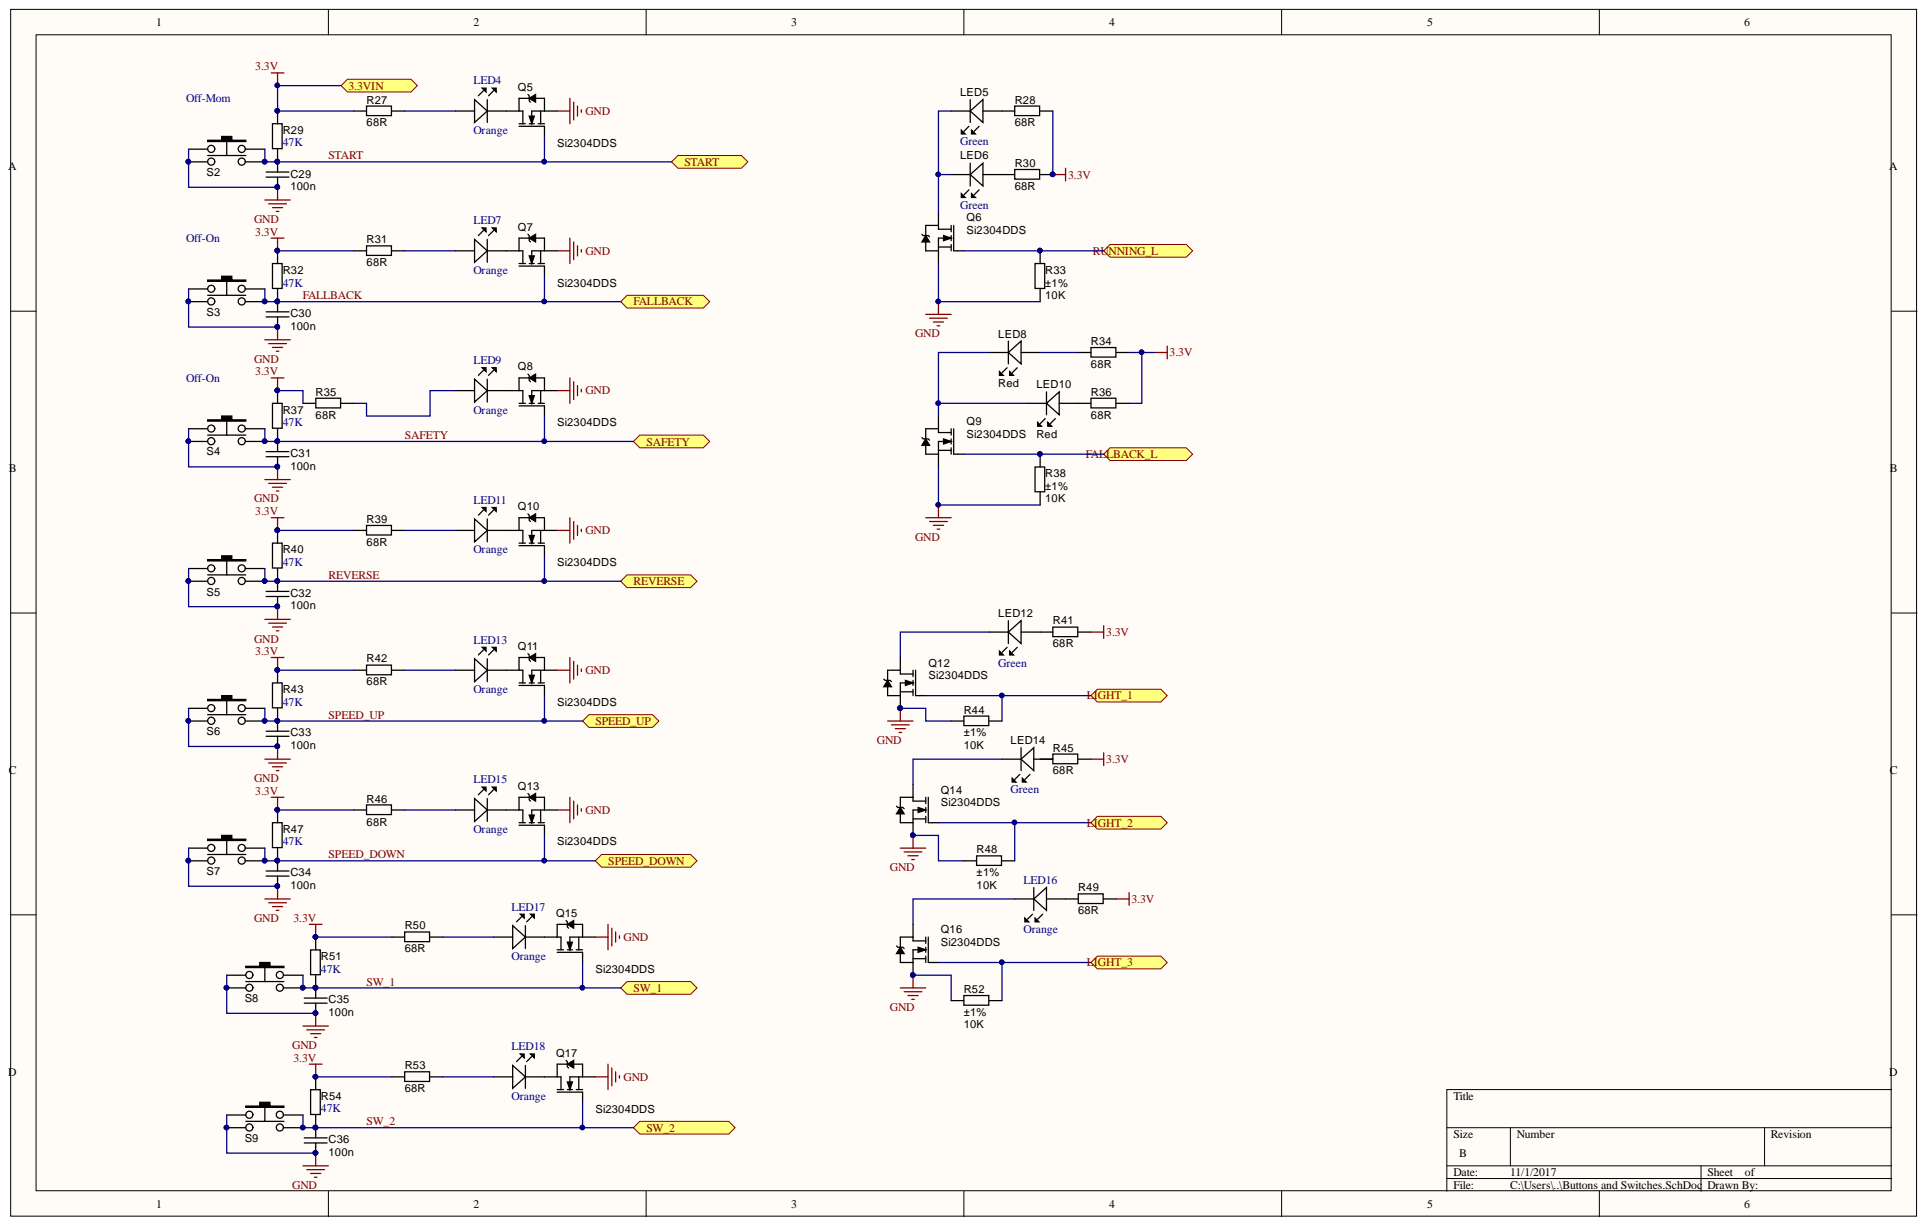
[picture p7: page 1]
