rvasquez6089/Senior-Design-VFD/Inverter/Half_Bridge.pdf

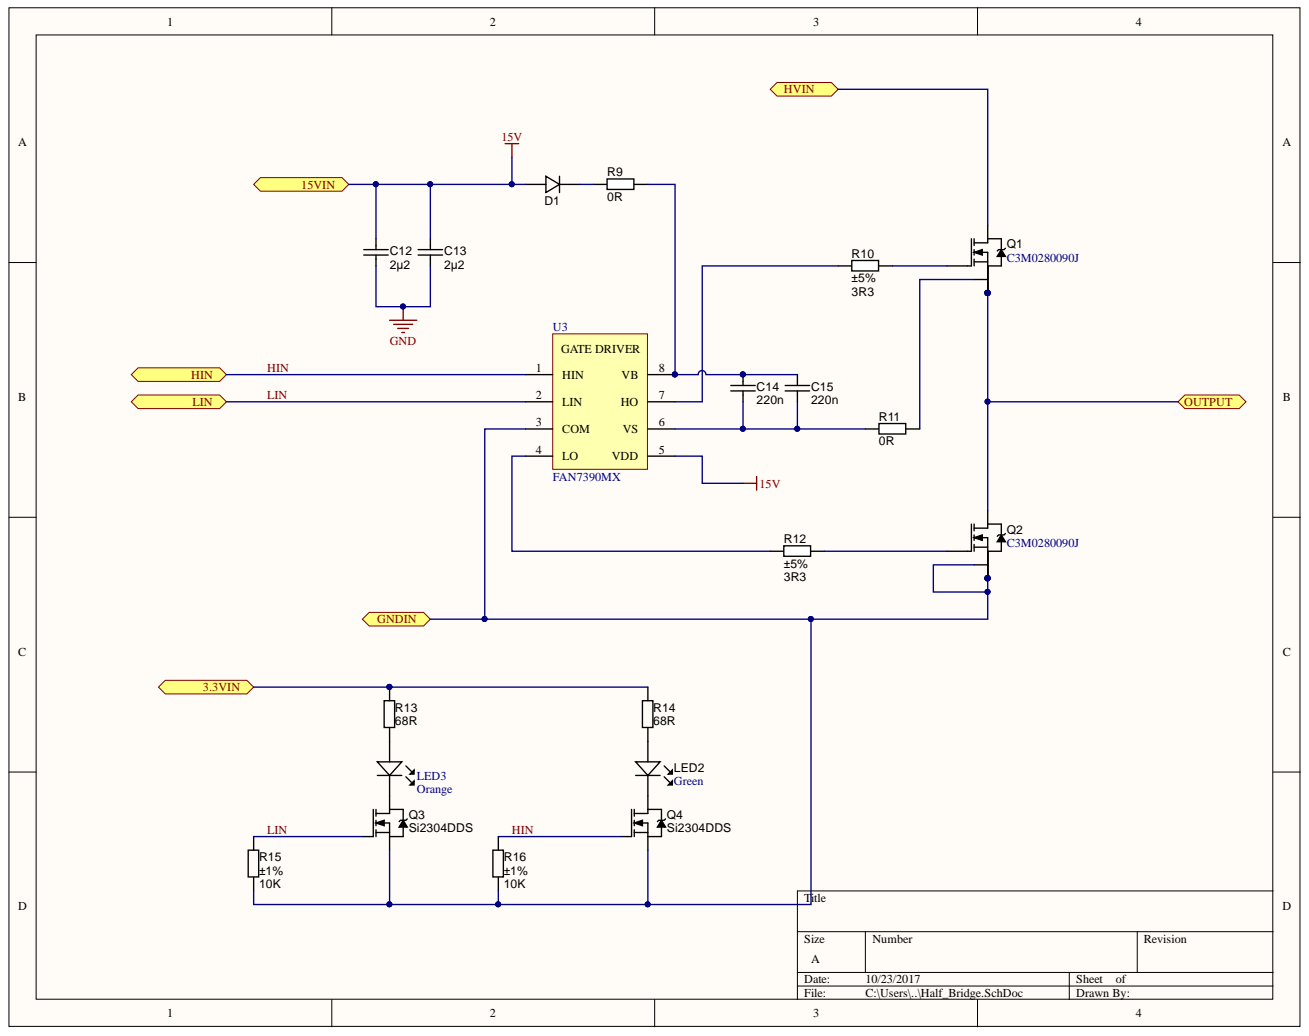
[picture p8: page 1]
