rvasquez6089/Senior-Design-VFD/Inverter/InverterPCB.pdf

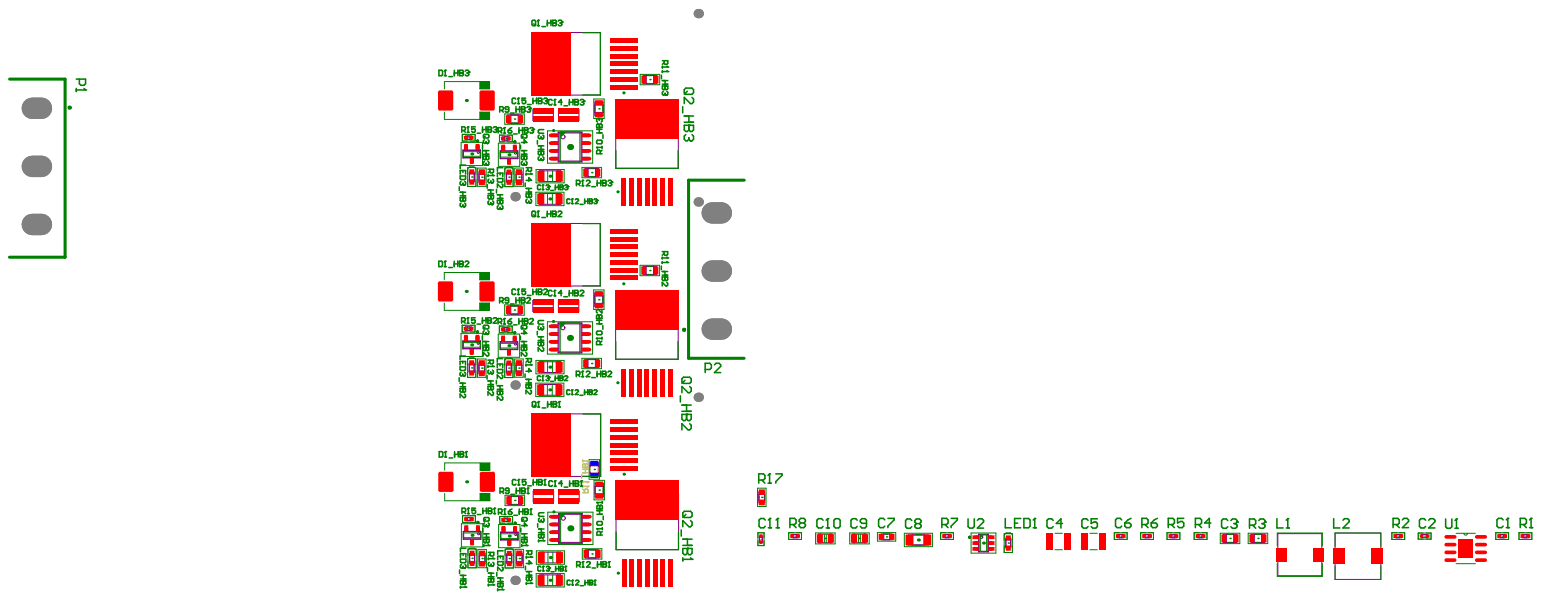
[picture p9: page 1]
