rvasquez6089/Senior-Design-VFD/(list of files, drawings)

Other design files:
Inverter/3.3V2.5A Microcontroller Power/3.3V2.5A Microcontroller Power.schdoc
Inverter/3.3V2.5A Microcontroller Power/3.PcbLib
Inverter/3.3V2.5A Microcontroller Power/LIB1.SchLib
Inverter/Button.SchDoc
Inverter/Buttons and Switches.SchDoc
Inverter/Half_Bridge.SchDoc
Inverter/Inverter Main.SchDoc
Inverter/Inverter.PrjPcb
Inverter/InverterPCB.PcbDoc
Inverter/Microcontroller.SchDoc
Power Factor Correction/Design Files/Main.SchDoc
Power Factor Correction/Design Files/Power Factor Correction.PrjPcb
Power Factor Correction/Design Files/Power Factor Correction.SchDoc
Power Factor Correction/Design Files/Power-Factor-Correction.PrjPcb
Power Factor Correction/Design Files/VFD.PcbDoc
