rvasquez6089/Senior-Design-VFD/(commit log)

2017-08-23 Started PFC Schematic
    [Main.SchDoc, Possible PFC Chips.xlsx, Power Factor Correction.PrjPcb, Power Factor Correction.SchDoc, Power-Factor-Correction.PrjPcb, UC2855A Calculations.xlsx, VFD.PcbDoc]
2017-08-28 Completed Preliminary Schematic of Version 1.0 of the PFC
    [Power Factor Correction.SchDoc, Power-Factor-Correction.PrjPcb, VFD.PcbDoc]
2017-08-28 Created PDF schematic
    [Power-Factor-Correction.PrjPcb]
2017-08-30 competed rev 1 pcb design
    [Power Factor Correction.SchDoc, Power-Factor-Correction.PrjPcb]
2017-09-15 created manufacturing outputs
    [Power Factor Correction.SchDoc, Power-Factor-Correction.csv, Power-Factor-Correction.xls, Power-Factor-Correction.xlsx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]
2017-10-23 Started inverter Design
    [1281330688.sldasm, 3.3V2.5A Microcontroller Power.schdoc, 3.PcbLib, 42ctq030.sldprt, 809534704.sldasm, 809572592.sldasm, 809573488.sldasm, 809727544.sldasm]
2017-10-25 Merge remote-tracking branch 'origin/master'
    # Conflicts:
    # Power Factor Correction/Design Files/History/VFD.~(14).PcbDoc.Zip
    # Power Factor Correction/Design Files/History/VFD.~(15).PcbDoc.Zip
    # Power Factor Correction/Design Files/Project Outputs for
    Power-Factor-Correction/Status Report.Txt
    # Power Factor Correction/Design Files/Project Outputs for
    Power-Factor-Correction/VFD-macro.APR_LIB
    # Power Factor Correction/Design Files/Project Outputs for
    Power-Factor-Correction/VFD.DRR
    # Power Factor Correction/Design Files/Project Outputs for
    Power-Factor-Correction/VFD.EXTREP
    # Power Factor Correction/Design Files/Project Outputs for
    Power-Factor-Correction/VFD.GBL
    # Power Factor Correction/De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
    [3.3V2.5A Microcontroller Power.schdoc, Inverter Main.SchDoc, InverterPCB.PcbDoc]
2017-10-26 almost done
    [Buttons and Switches.SchDoc, Half_Bridge.SchDoc, Inverter Main.SchDoc, Inverter.PrjPcb]
2017-10-31 Almost done with the schematic
    [3.3V2.5A Microcontroller Power.schdoc, Buttons and Switches.SchDoc, Half_Bridge.SchDoc, Inverter Main.SchDoc]
2017-11-01 Laying out the board
    [3.3V2.5A Microcontroller Power.schdoc, Buttons and Switches.SchDoc, Half_Bridge.SchDoc, Inverter Main.SchDoc, Inverter.PrjPcb]
2017-11-09 Inverter and PFC REV 1 Completed
    [3.3V2.5A Microcontroller Power.schdoc, Button.SchDoc, Buttons and Switches.SchDoc, Inverter Main.SchDoc, Inverter.PrjPcb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]
2017-11-09 Working on REV 2 of the PFC
    [Boot Strap Capacitor Calculations.xlsx]
2017-11-09 working on REV 2 of PFC
    [Power Factor Correction.SchDoc, Power-Factor-Correction.PrjPcb]
2017-11-09 working on REV2 of PFC PCB
    [Boot Strap Capacitor Calculations.xlsx]
2017-11-10 Working finished rev 2 of PCF PCB and creating BOMS
    [Button.SchDoc, Inverter BOM.xls, Inverter Main.SchDoc, Inverter.PrjPcb, Power Factor Correction.SchDoc, Power-Factor-Correction.PrjPcb, VFD.PcbDoc]
2017-11-10 Generated Fabrication out puts
    I need to work on the silkscreen labels, they are sloppy AF
    [Inverter.PrjPcb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]
2017-11-20 created boms and 3d models
    [BFB0512L (1).SLDPRT, BFB0512L (1).stp, Enclosure Bottom.STEP, Enclosure Bottom.sldprt, Inverter BOM.xls, InverterPCB BOM.xls, LID1.SLDPRT, LID10.SLDPRT]
2018-08-11 Some updates to the Git
    [Power-Factor-Correction BOM .xls]
